jaith-krishh/lifi/(commit log)

2026-10-11 Add LiFi optical transmitter sketch for Arduino Nano
    Pulse-width OOK transmitter with pot-selected preset messages, serial
    custom message, length + XOR checksum framing, and a build guide.
    Claude-Session: https://claude.ai/code/session_01E158ACCofRNBke1C2kNLzE
2026-10-11 Add ESP32 receiver, web dashboard, link simulation and project docs
    - receiver_esp32: 1 kHz sampling on a dedicated FreeRTOS task, threshold
    slicer with hysteresis (auto or pot-set), pulse-width decoder that
    measures LDR lag on the preamble and corrects every bit, XOR checksum
    validation, buzzer chirps, and a self-hosted dashboard (AP + captive
    portal, optional STA + mDNS) with live scope, stats and frame log.
    - LiFiDecoder.h is plain C++ so tests/link_sim.cpp runs the same decoder
    against a simulated transmitter, LDR lag and ADC noise.
    - Add an LDR_SAFE timing profile to both boards for slow LDRs.
    - Project README with quick start, protocol, demo script and concepts.
    Co-Authored-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
    [LiFiDecoder.h, link_sim.cpp, receiver_esp32.ino, transmitter_nano.ino]
2026-10-11 Add transmitter hardware setup guide and wiring diagram
    Step-by-step breadboard build, part identification, power-on test with
    troubleshooting table, beam aiming tips, and an optional transistor
    driver for more range.
    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
2026-10-11 Share the Nano frame encoder with the tests and add live telemetry
    - transmitter_nano/LiFiEncoder.h: frame builder, symbol emitter and both
    timing profiles as plain C++. The sketch and tests/link_sim.cpp now use
    the same code, so the simulation exercises the real transmitter.
    - New LIVE telemetry slot: the Nano sends its internal chip temperature,
    supply voltage and frame number (no extra parts). Replaces the fixed
    "TEMP:27C" preset.
    - LDR_SAFE on the Nano is now `#define LIFI_TX_LDR_SAFE`, matching the
    receiver's style.
    - tests: encoder unit checks, and profile_check.cpp, which verifies the
    transmitter and receiver timing tables match in both profiles.
    - Transmitter README: zone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
    [LiFiEncoder.h, link_sim.cpp, profile_check.cpp, transmitter_nano.ino]
